Pooja-Goel07/PoseGuide/(commit log)

2026-04-10 feat: Add stick figure drawing, API data fetching, and ESP32 WiFi test
2026-05-18 feat: complete real-time posture tracking pipeline from wearable sensors to interactive dashboard
